MicroMidi/VOX-Adio-Air-MIDI-Footswitch/(commit log)

2021-12-15 Add files via upload
    First prototype for ESP32 board, 7 segment display and Vox Adio Air amp,
2021-12-29 Update 47FX-BLE-Client-Vox-Taster-ButtonLib-7Seg.ino
    - Added button for down-switching of effects
    - Handle MIDI callbacks for effect-switching from Adio Amp
2022-10-15 Add files via upload
    Add source code for generic ESP32 modules with OLED display
2022-10-15 Add files via upload
    Add source code for Heltec ESP32 WiFi Kit with integrated OLED display
